blackjetrock/z80_shield/docs/images/c1_soldered.jpg

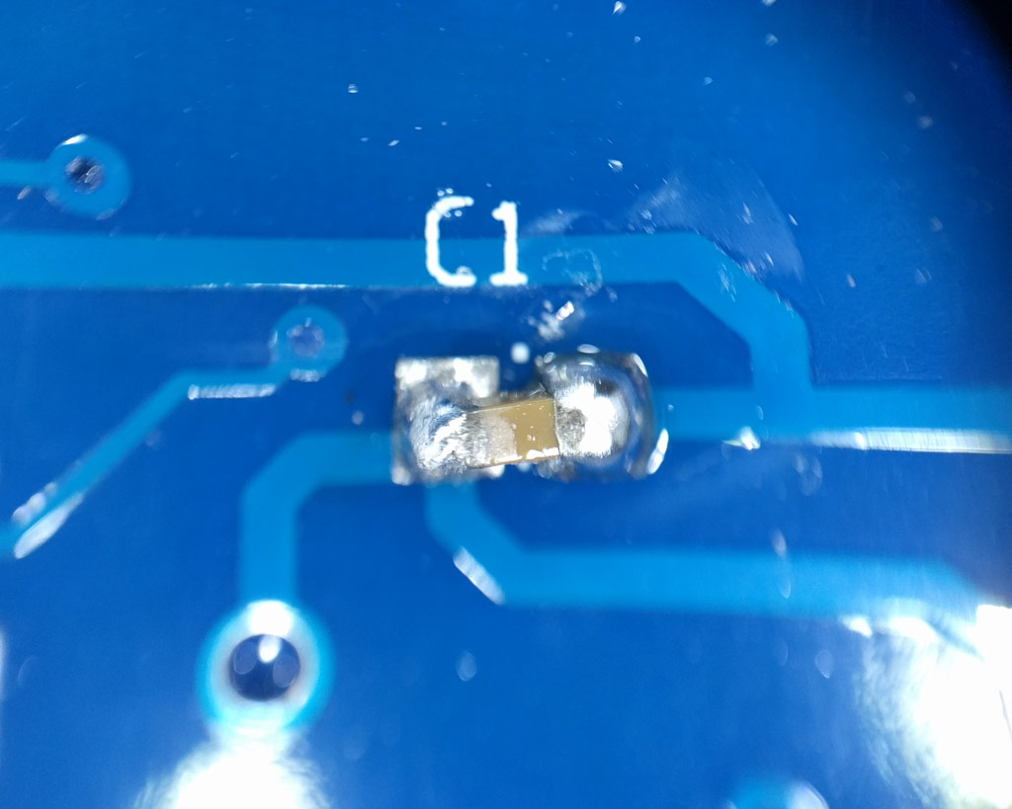
docs/images/c1_soldered.jpg
