blackjetrock/z80_shield/docs/images/fix_wire_connections.jpg

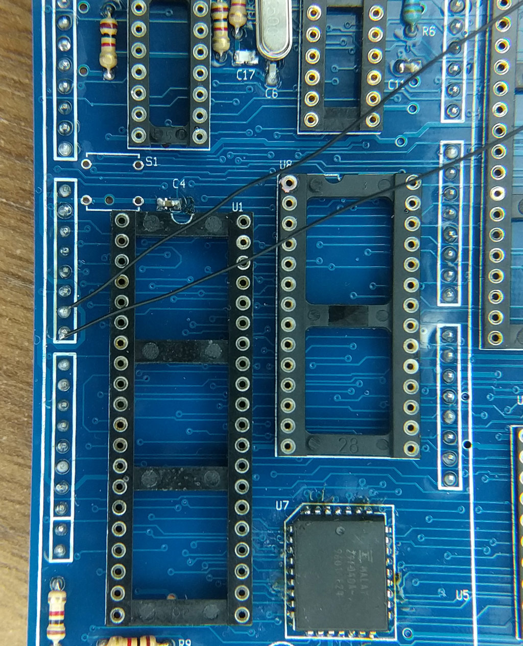
docs/images/fix_wire_connections.jpg
