blackjetrock/z80_shield/datasheets/Pin Arduino Mega 2660.jpg

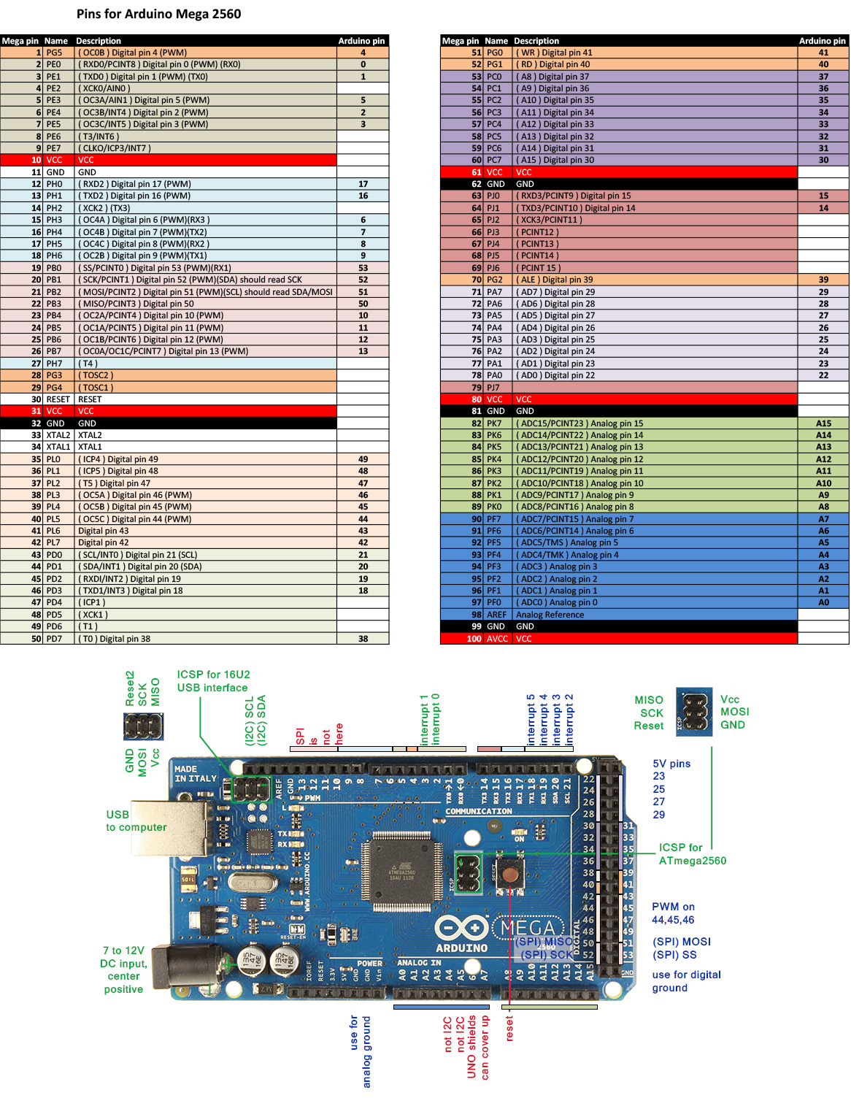
datasheets/Pin Arduino Mega 2660.jpg
