blackjetrock/z80_shield/docs/images/arduino_connectors_prep.jpg

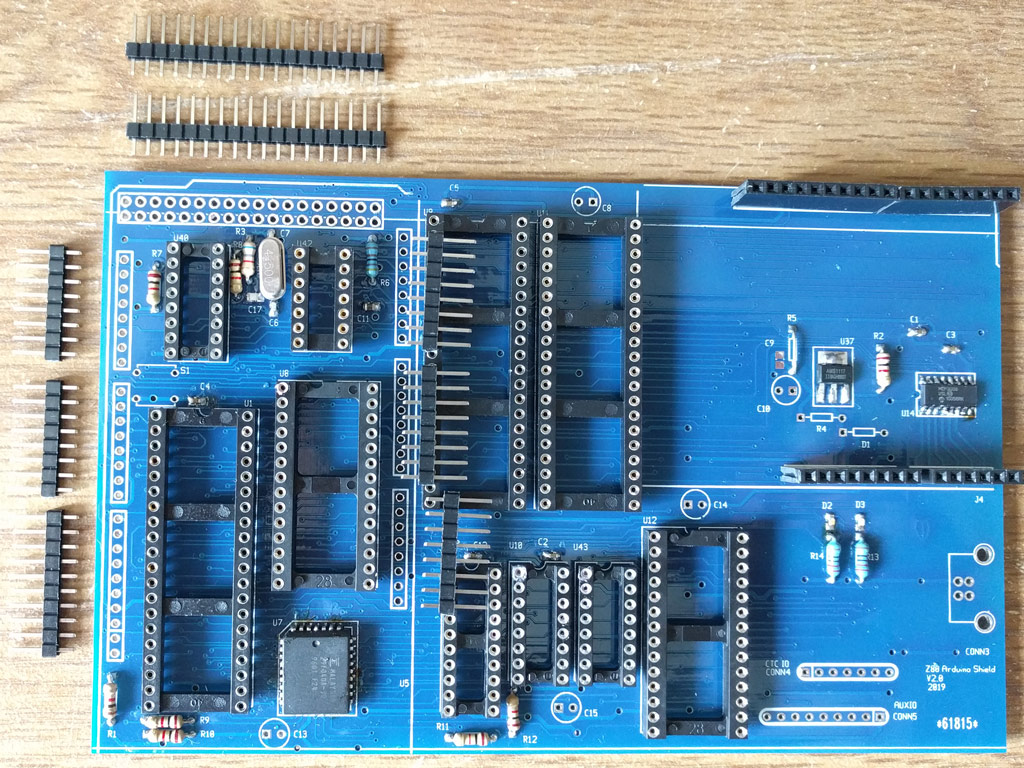
docs/images/arduino_connectors_prep.jpg
