blackjetrock/z80_shield/docs/images/bits.jpg

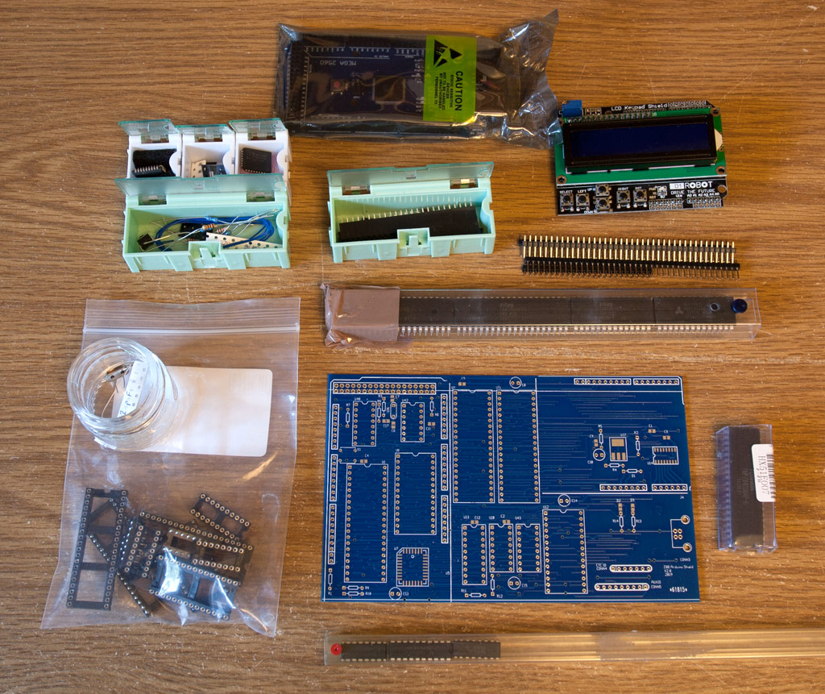
docs/images/bits.jpg
