blackjetrock/z80_shield/docs/images/c1_prep.jpg

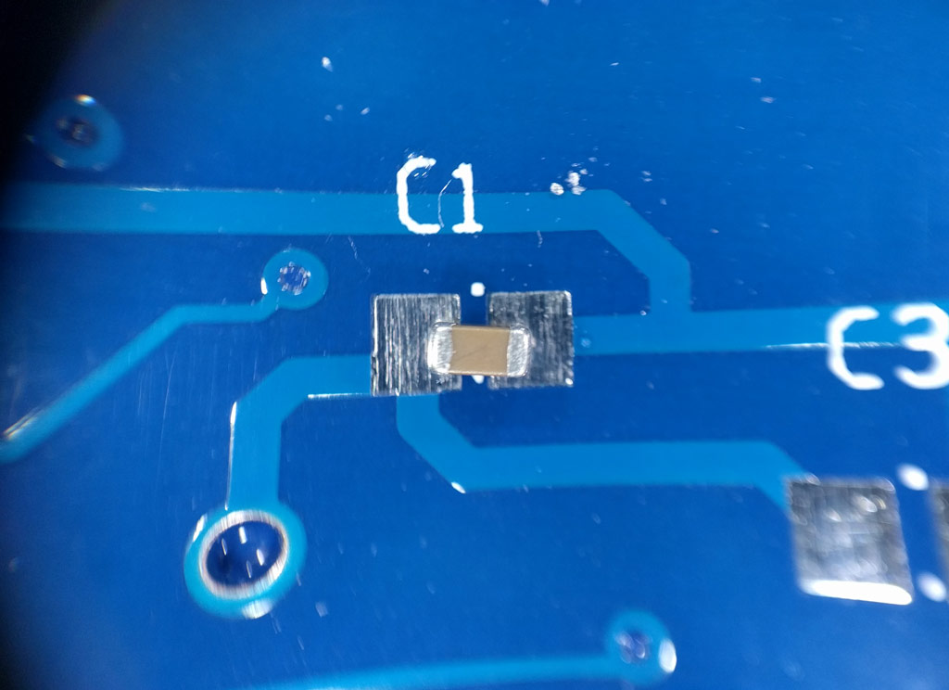
docs/images/c1_prep.jpg
