blackjetrock/z80_shield/docs/images/complete.jpg

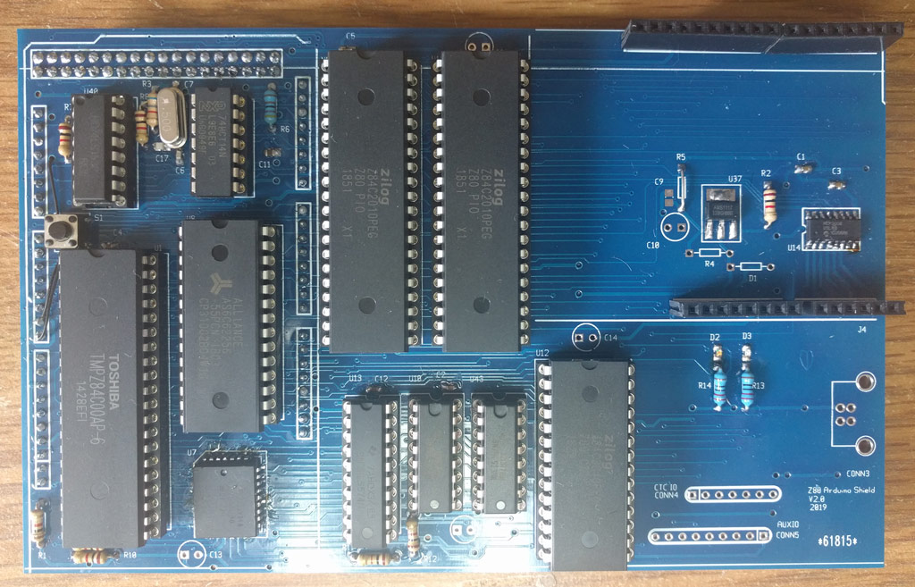
docs/images/complete.jpg
