blackjetrock/z80_shield/docs/images/flash_clamp.jpg

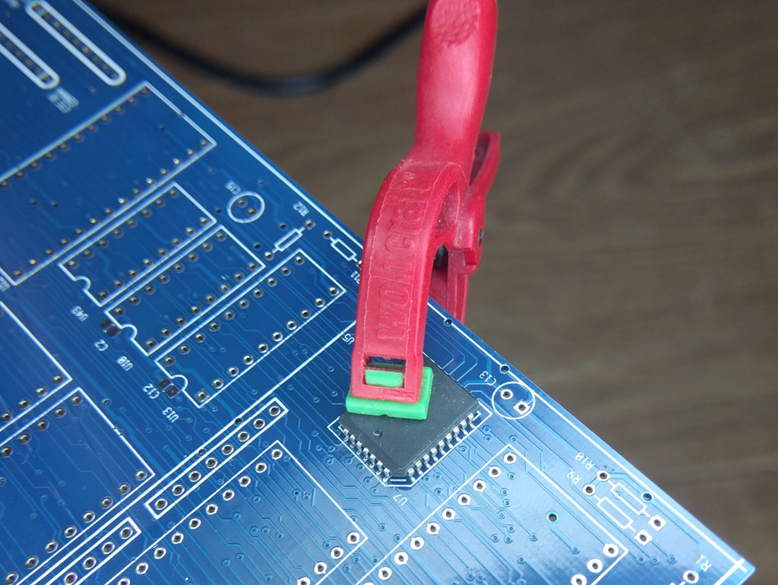
docs/images/flash_clamp.jpg
