blackjetrock/z80_shield/docs/images/flash_clamp_detail.jpg

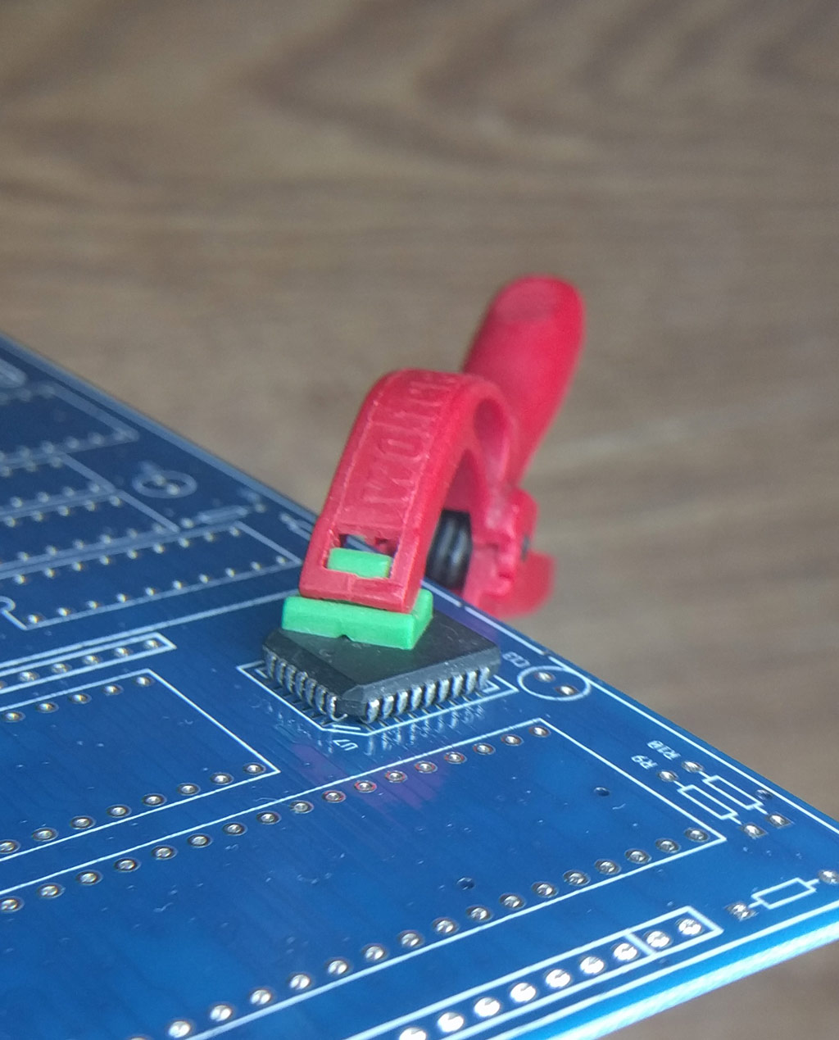
docs/images/flash_clamp_detail.jpg
