blackjetrock/z80_shield/docs/images/flash_prep.jpg

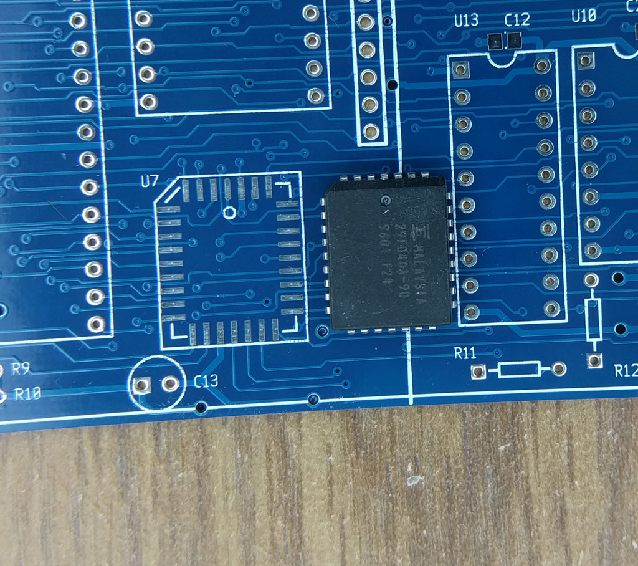
docs/images/flash_prep.jpg
