blackjetrock/z80_shield/docs/images/r5_0ohm.jpg

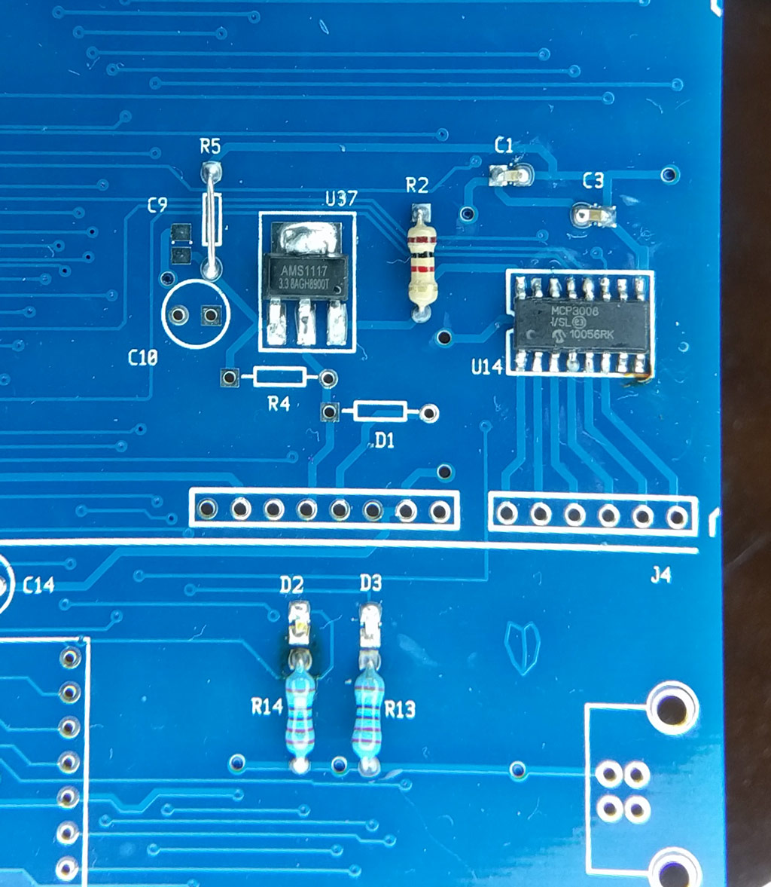
docs/images/r5_0ohm.jpg
