blackjetrock/z80_shield/docs/images/resistors_done.jpg

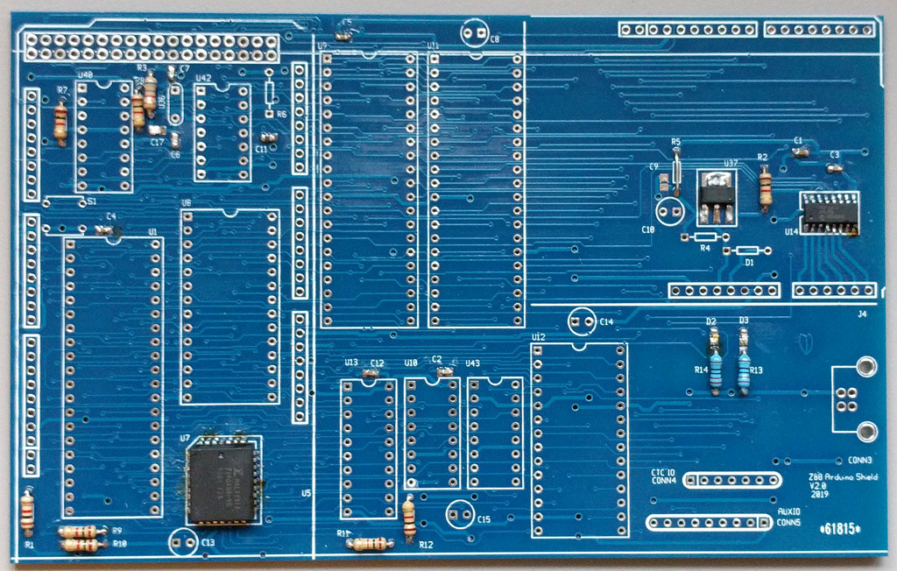
docs/images/resistors_done.jpg
