blackjetrock/z80_shield/docs/images/shield_sockets_prep.jpg

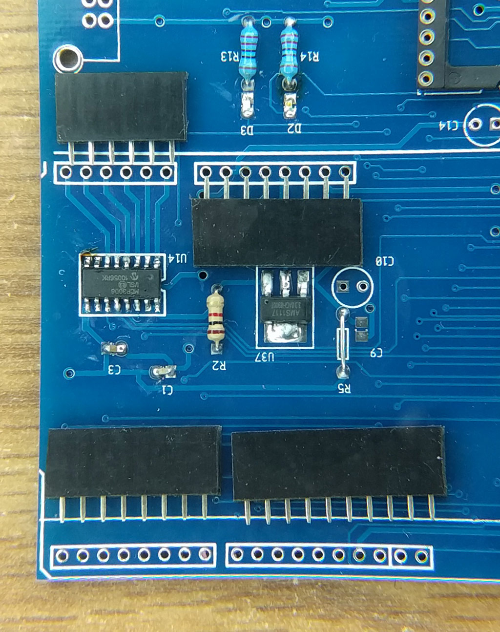
docs/images/shield_sockets_prep.jpg
