blackjetrock/z80_shield/docs/images/sm_done.jpg

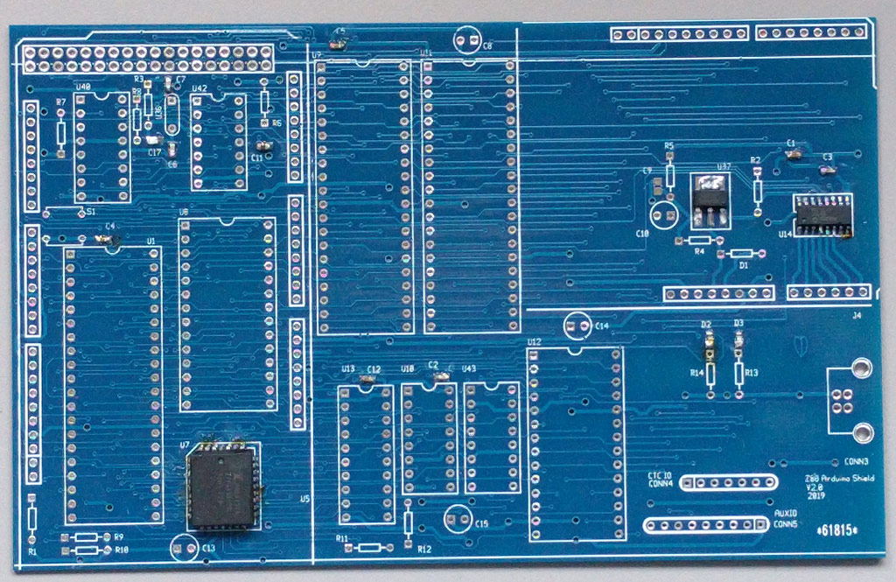
docs/images/sm_done.jpg
