blackjetrock/z80_shield/docs/images/sockets_done.jpg

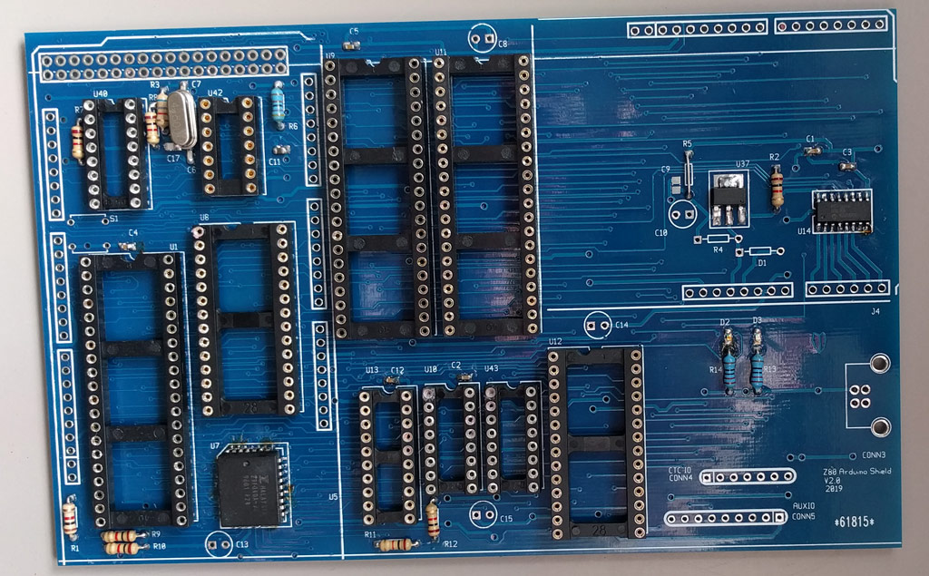
docs/images/sockets_done.jpg
