blackjetrock/z80_shield/docs/images/u9_cuts.jpg

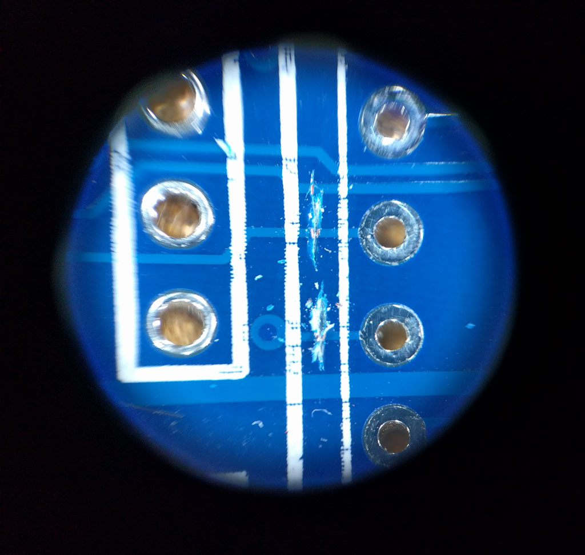
docs/images/u9_cuts.jpg
