blackjetrock/z80_shield/docs/images/u9_switch.jpg

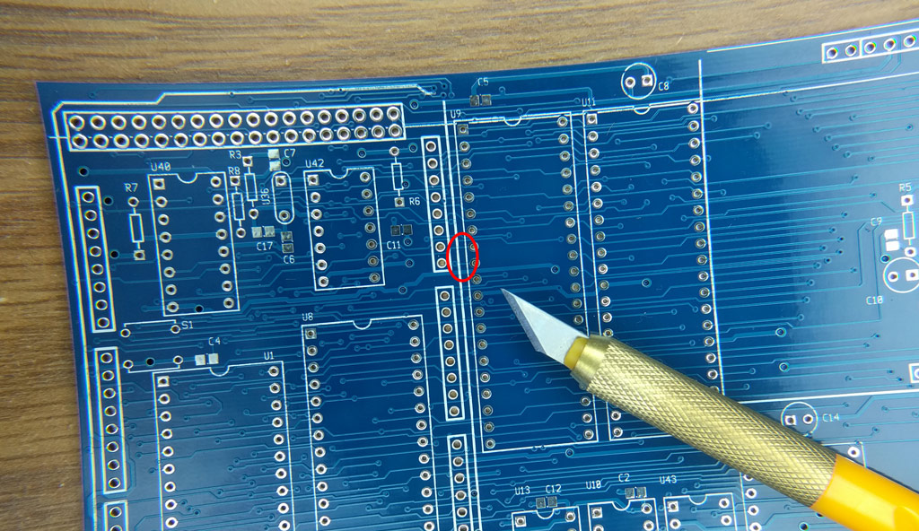
docs/images/u9_switch.jpg
