blackjetrock/z80_shield/docs/images/u14_clamp.jpg

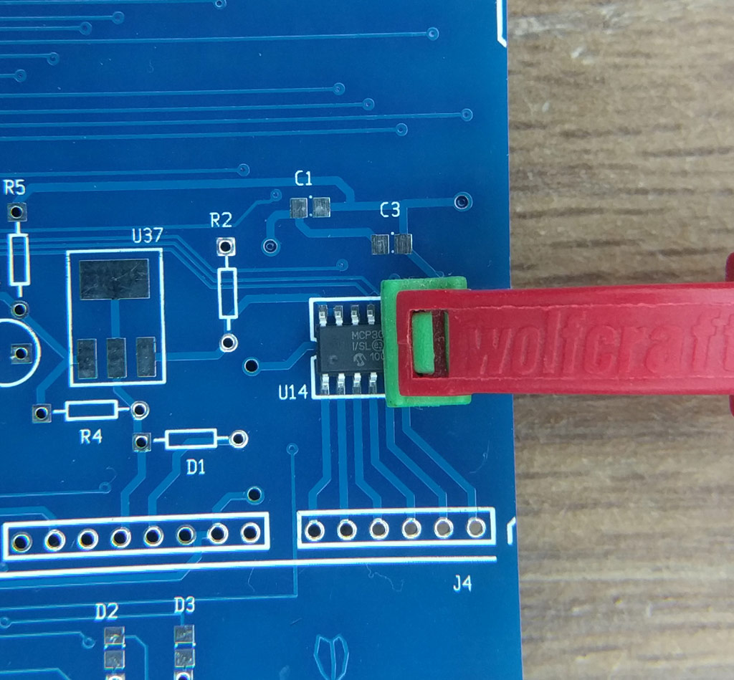
docs/images/u14_clamp.jpg
