blackjetrock/z80_shield/docs/images/u14_prep.jpg

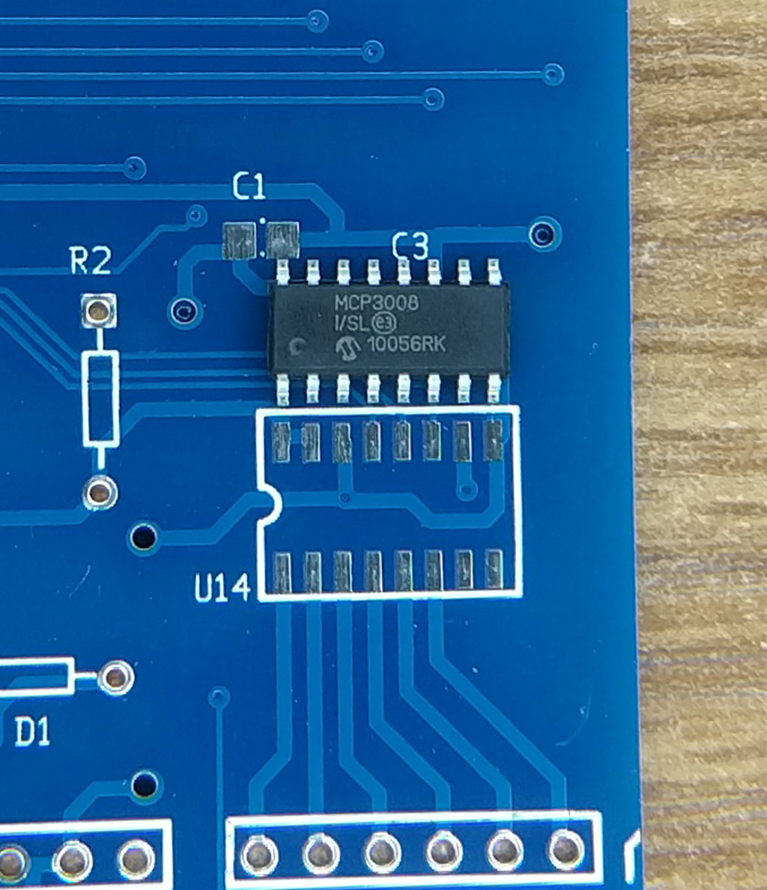
docs/images/u14_prep.jpg
