blackjetrock/z80_shield/docs/images/u36_crystal.jpg

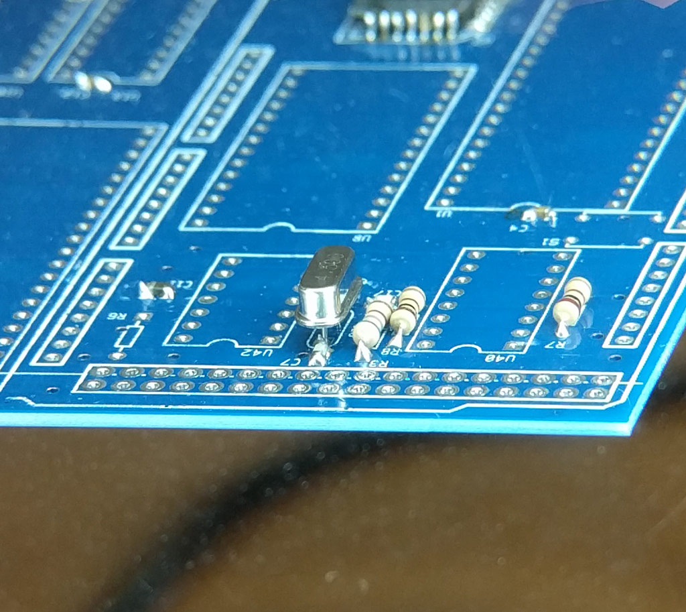
docs/images/u36_crystal.jpg
