blackjetrock/z80_shield/docs/images/u37_prep.jpg

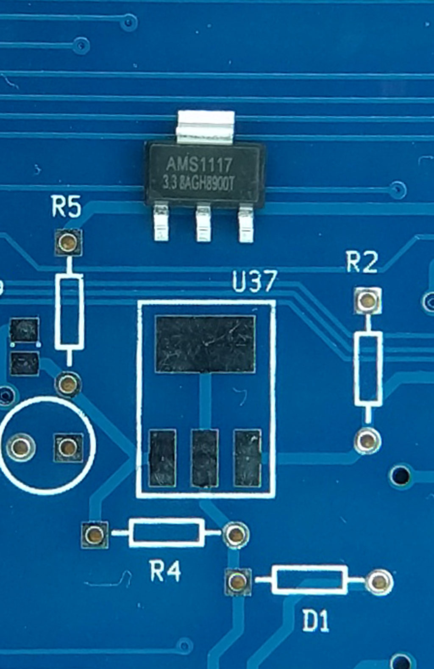
docs/images/u37_prep.jpg
