blackjetrock/z80_shield/docs/images/arduino_connectors_soldered.jpg

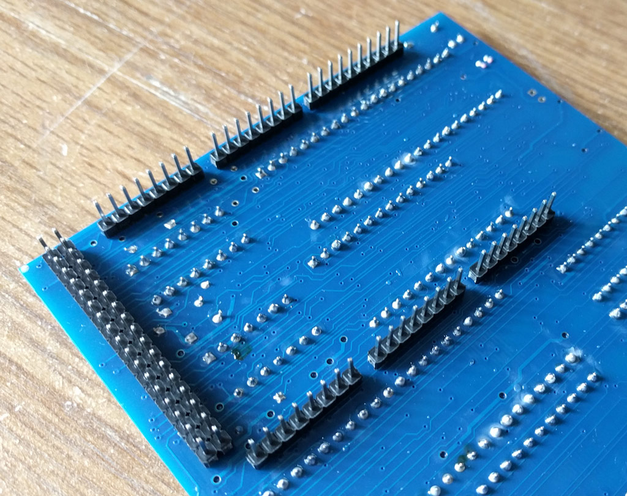
docs/images/arduino_connectors_soldered.jpg
