blackjetrock/z80_shield/docs/images/flash_soldered.jpg

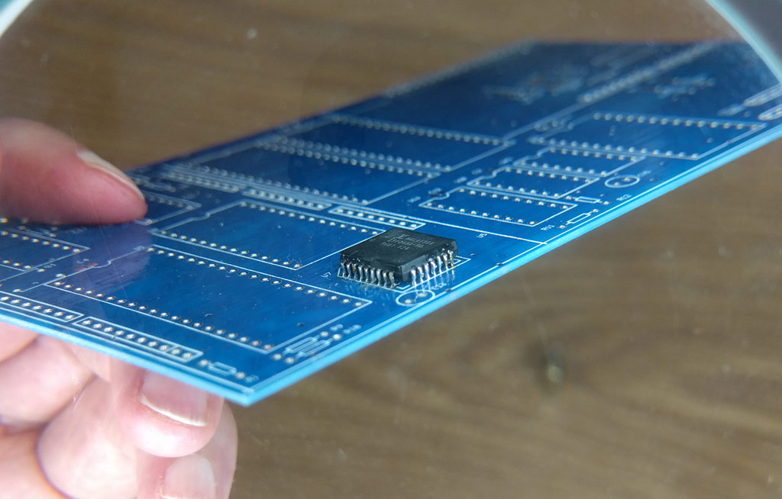
docs/images/flash_soldered.jpg
