blackjetrock/z80_shield/docs/images/shield_sockets_soldered.jpg

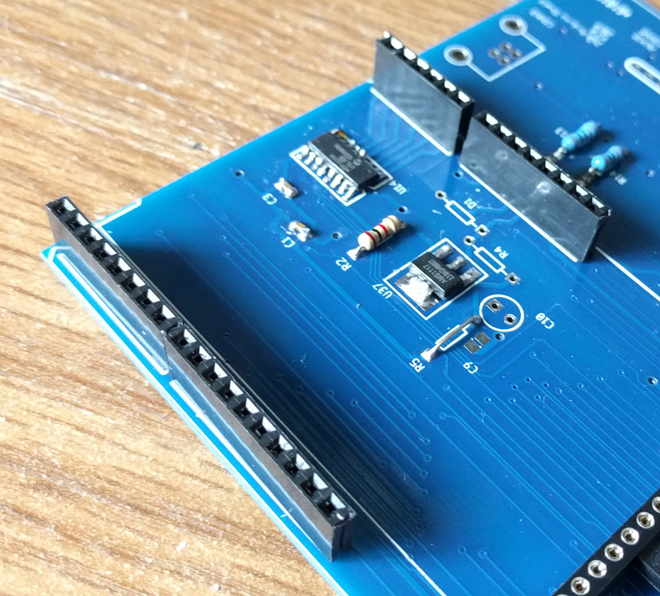
docs/images/shield_sockets_soldered.jpg
