blackjetrock/z80_shield/docs/images/u14_soldered.jpg

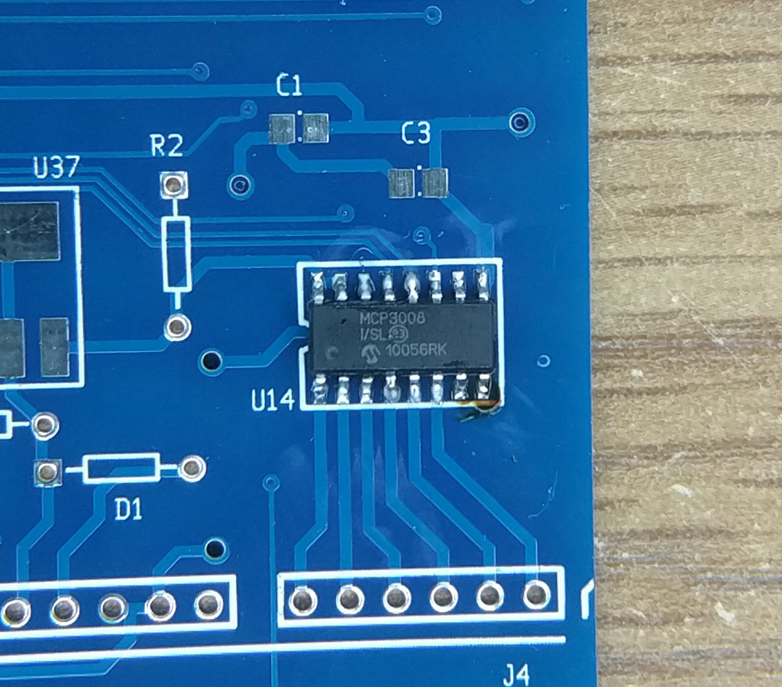
docs/images/u14_soldered.jpg
