blackjetrock/z80_shield/docs/images/u37_soldered.jpg

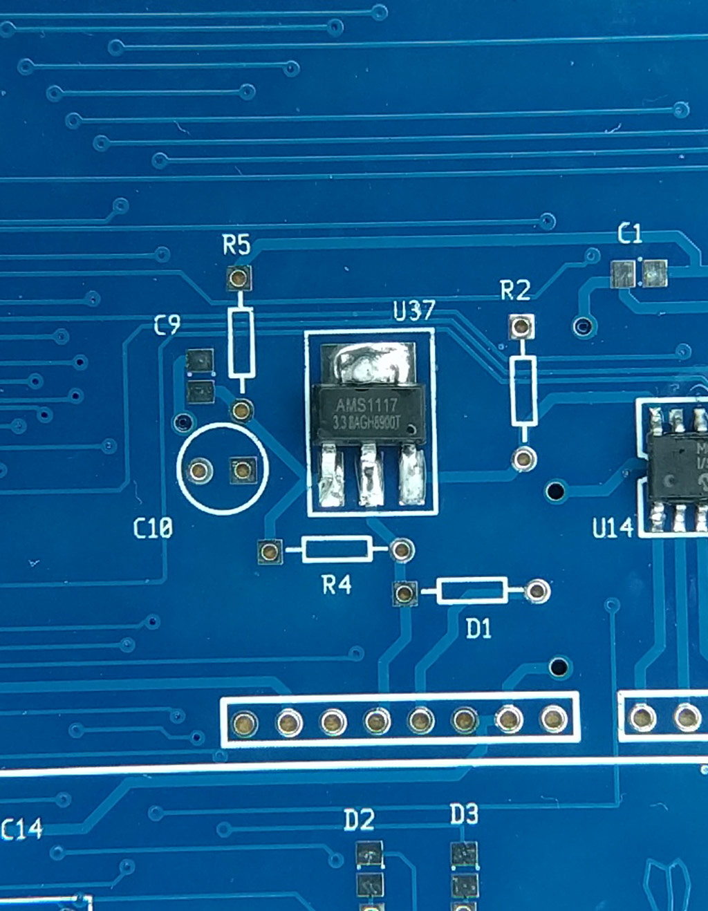
docs/images/u37_soldered.jpg
