blackjetrock/z80_shield/docs/images/fix_wire_topside.jpg

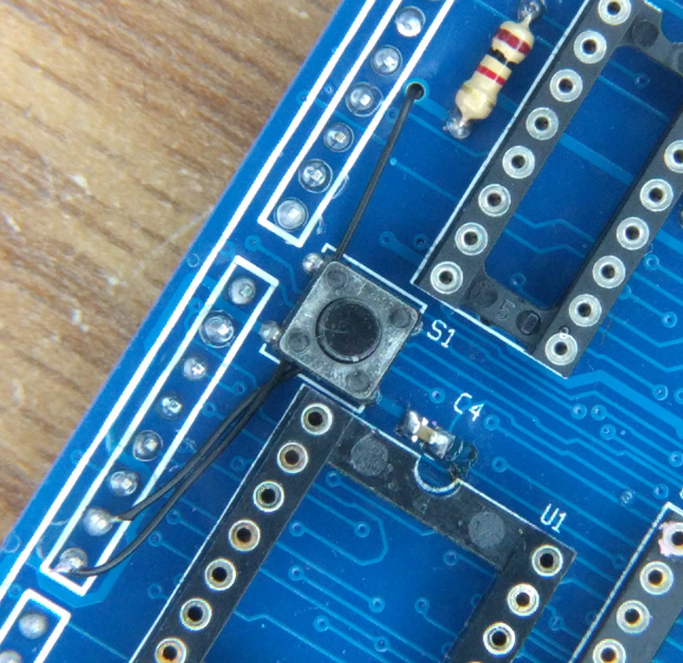
docs/images/fix_wire_topside.jpg
