blackjetrock/z80_shield/docs/images/fix_wire_underside.jpg

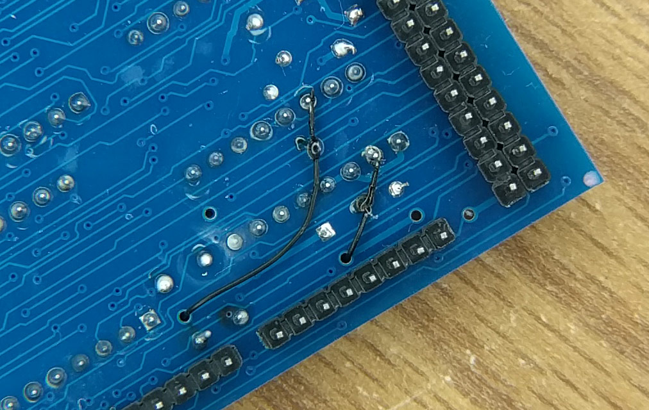
docs/images/fix_wire_underside.jpg
