blackjetrock/z80_shield/z80_shield_v_2_0.pdf

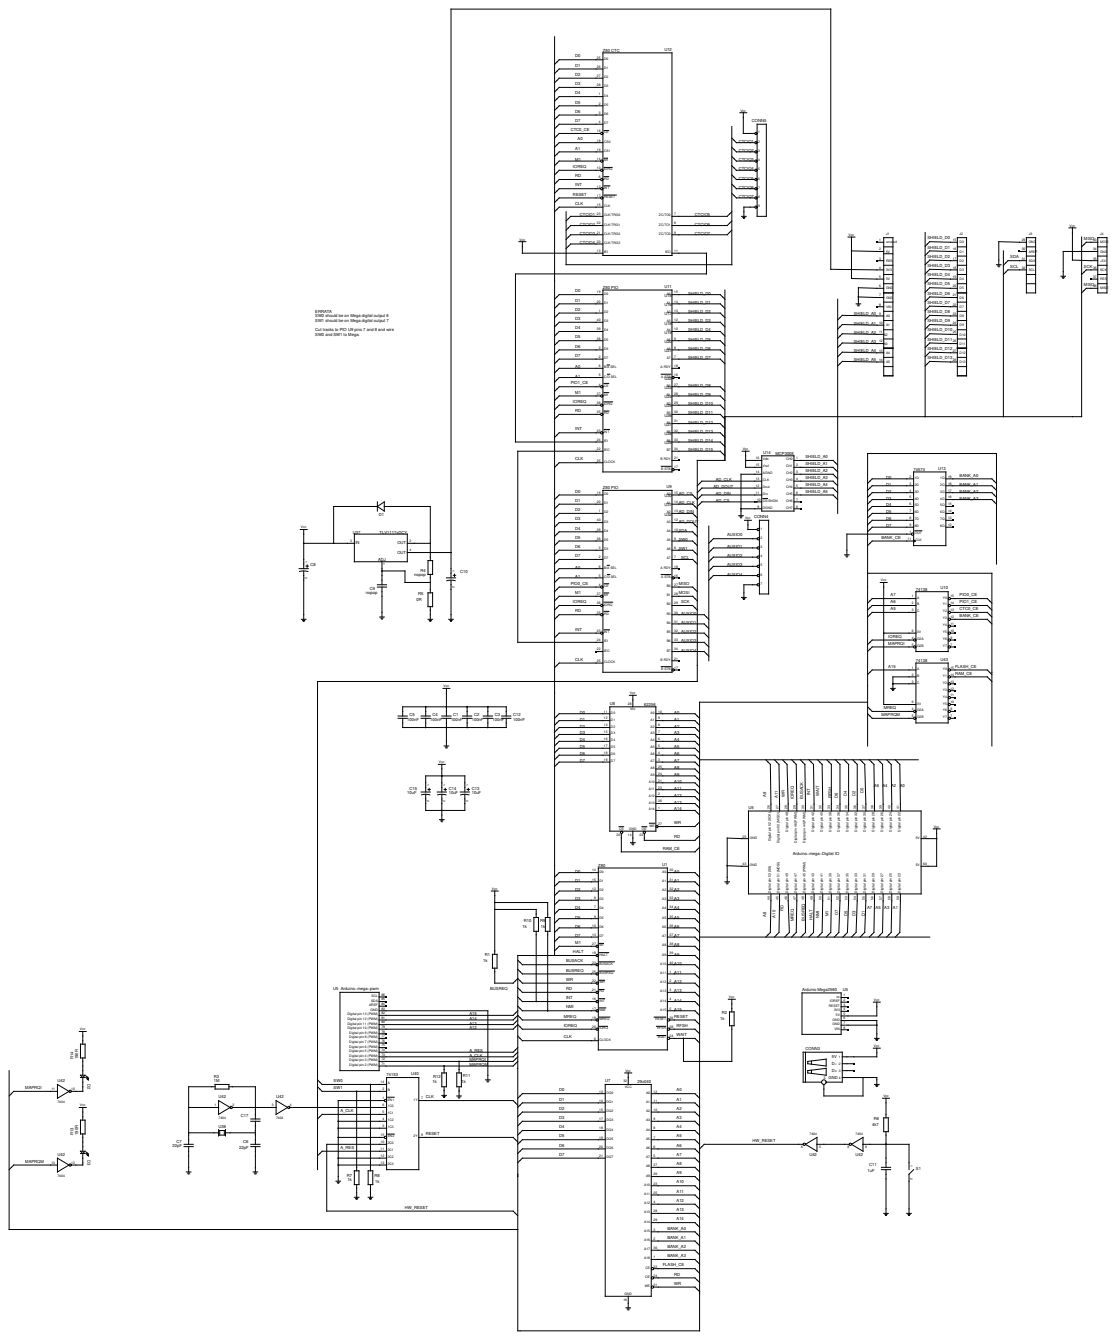
[picture p29: page 1]

CTCIO2 | CTCIO6

CTCIO3 | CTCIO7

19 D0 D1 20 D1 1 D2 40 D3 39 D4 38 D5 3 D3 2 D7 6 B/A SEL 5 C/D SEL 4 CE 37 M1 36 IORQ 35 RD 23 INT 24 IEI 22 IEO 25 CLOCK | U15 U16 U17 U18 U19 U20 U21 | 15 A0 14 A1 SHIELD_D1 13 A2 12 A3 10 A4 9 A5 8 A6 7 A7 18 A RDY

ERRATA
SW0 should be on Mega digital output 6
SW1 should be on Mega digital output 7

D2 | | SHIELD_D2

Cut tracks to PIO U9 pins 7 and 8 and wire
SW0 and SW1 to Mega.

PIO1_CE A1 | U22 U23 U24 U25 U26 U27 U28 U29 | 16 A STB 27 B0 28 B1 29 B2 30 B3 31 B4 32 B5 33 B6 34 B7 21 B RDY

IOREQ | SHIELD_D10

M1 | SHIELD_D9

RD | SHIELD_D11

INT | SHIELD_D12 | U14

D3 | AD_DOUT | D6

C4 100nF Vcc | Vcc C1 C3 C12 100nF 100nF 100nF Vcc | Vcc

D1 12 D1 13 D2 16 D4 15 D3 17 D5 18 D6 19 D7 | Vcc D0 CS GND OE | 10 A0 11 9 A1 A1 8 A2 6 A4 7 A3 5 A5 4 A6 3 A7 25 A8 24 A9 21 A10 23 A11 2 A12 26 A13 1 A14 | MREQ MAPRQM

26 Digital pin 52 (SCK) 44 Digital pin 53 (SS) 25 GND 43 GND Arduino−mega−Digital IO U5

27 Digital pin 50 (MISO) 45 Digital pin 51 (MOSI)

28 Digital pin 48 46 Digital pin 49

29 Digital pin 46 (PWM) 47 Digital pin 47

30 Digital pin 44 (PWM) 48 Digital pin 45 (PWM)

31 Digital pin 42 49 Digital pin 43

32 Digital pin 40 50 Digital pin 41

33 Digital pin 38 51 Digital pin 39

34 Digital pin 36 52 Digital pin 37

35 Digital pin 34 53 Digital pin 35

36 Digital pin 32 54 Digital pin 33

37 Digital pin 30 55 Digital pin 31

38 Digital pin 28 56 Digital pin 29

39 Digital pin 26 57 Digital pin 27

40 Digital pin 24 58 Digital pin 25

41 Digital pin 22 59 Digital pin 23

A_CLK | | RESET | D2 | A2
