blackjetrock/z80_shield/(list of files, drawings)

Other design files:
old_dirty/z80_shield1.pcb
z80_shield1.pcb
z80_shield_v_2_0.pcb
z80_shield_v_2_1.pcb
