blackjetrock/z80_shield/(commit log)

2019-04-18 Initial files
    [z80_shield1.sch]
2019-04-18 Added ADC
    [z80_shield1.sch]
2019-04-18 Updated datasheets and schematic
2019-04-18 Added schematic
    [z80_shield1.sch]
2019-04-19 Added PCB and latest sch changes
    [z80_shield1.pcb]
2019-04-19 PCB created and more datasheets
2019-04-21 Schematic updates and PCB layout started
    [z80_shield1.pcb, z80_shield1.sch]
2019-04-24 More layout, now routed
    [z80_shield1.pcb]
2019-04-24 More changes
    [z80_shield1.sch]
2019-04-25 Added aux io connectors
    [z80_shield1.sch]
2019-04-25 Fully routed and design rule checked
    [z80_shield1.pcb]
2019-04-26 Added A0/A1 to PIOs
    [z80_shield1.sch]
2019-04-26 laid out and titles added. Silk tidied. traxcks tidied. DRC fine, apart from via size and silk line thickness.
    [z80_shield1.pcb]
2019-05-02 Minor changes
    [z80_shield1.pcb]
2019-05-02 Added Dirty PCBs Zip files. V1_1 was sent off for sirst batch
2019-05-02 Start of V1.2 changes
    [z80_shield1.sch]
2019-05-02 Start of V1.2 fixes
    [z80_shield1.pcb]
2019-05-03 Mega sketch updates and errata changes
    [z80_shield.ino]
2019-05-03 More errata and some more code for Mega
    [z80_shield.ino]
2019-05-03 Fixed items 4 and 5 (NT and NMI) in errata
    [z80_shield1.pcb, z80_shield1.sch]
2019-05-11 Added RFSH pin and cage layout pins
2019-05-12 Modified pinout to match rewired bad Mega layout
    [z80_shield1.pcb, z80_shield1.sch]
2019-05-20 Added code to write to RAM and also to bank register Runs on V1_1 PCB.
2019-05-20 Added V1_1 PCB files, or a close as i can get. Should have copied them.
    [z80_shield_v_1_1.pcb, z80_shield_v_1_1.sch]
2019-05-20 Added old pcb and sch files for archive purposes
    [z80_shield1.pcb, z80_shield1.sch]
2019-05-21 Added forever loop command and more errata
    [z80_shield.ino]
2019-05-22 Added Z80 code and fixed memory menu
    [z80_shield.ino]
2019-05-22 Fixes ot memory menu
    [z80_shield.ino]
2019-05-24 Added errata Changed the memory access when tracing so that the RAM chipprovides RAM data. Moved data bus driving to bus state machine to do this. Added more Z80 code
    [z80_shield.ino]
2019-05-24 LCD Test working. Added V2 PCB and schematic. Added Z80 code examples
    [z80_shield_v_2_0.pcb, z80_shield_v_2_0.sch]
2019-05-25 Improved lcd test, added errata and some updates to V2 schematic
    [z80_shield_v_2_0.sch]
2019-05-28 Updated V2 schematic and PCB
    [z80_shield_v_2_0.pcb, z80_shield_v_2_0.sch]
2019-05-28 Delete z80_shield_v_2_0.pcb
    Deleting to get newer V2 file
    [z80_shield_v_2_0.pcb]
2019-05-28 Delete z80_shield_v_2_0.sch
    Deleting to get newer version
    [z80_shield_v_2_0.sch]
2019-05-28 Added new version 2 files
    [z80_shield_v_2_0.pcb, z80_shield_v_2_0.sch]
2019-05-28 PCB work
    [z80_shield_v_2_0.pcb]
2019-05-29 More routing
    [z80_shield_v_2_0.pcb, z80_shield_v_2_0.sch]
2019-05-31 V2.0 PCB that passes design rule check at 4mil, so probably ok for 6.
    [z80_shield_v_2_0.pcb, z80_shield_v_2_0.sch]
2019-05-31 More fixes, errors on schematic mainly.
    [z80_shield_v_2_0.pcb, z80_shield_v_2_0.sch]
2019-06-04 Final changes for V2. Added LEDs to MAPRQI and MAPRQM
    [z80_shield_v_2_0.pcb, z80_shield_v_2_0.sch]
2019-06-04 Changes to silk after viewing gerbers.
    [z80_shield_v_2_0.pcb]
2019-06-04 Another silk mod
    [z80_shield_v_2_0.pcb]
2019-06-14 Final changes before second PCB run.
    [z80_shield_v_2_0.pcb]
2019-06-23 Changes and new bom file for V2.0 PCB. Arduino sketch is now set up for V2.0 PCB.
2019-06-24 Embedded symbols in schematic
    [z80_shield_v_2_0.sch]
2019-09-03 A/D now sampling. Lcdtest Z80 code has sample display after LCD write.
2019-09-04 print addr or PC depending on M1 state
2019-09-04 add Z80 reset to main menu
    [z80_shield.ino]
2019-09-06 Swapped map request assertion messages
    [z80_shield.ino]
2019-09-06 Added upload fixes to both sides. Still doesn't send file
    [z80_shield.ino]
2019-09-06 tidy up trace menu
2019-09-22 PCB fixes and changes for V2.1 PCB
    [z80_shield_v_2_1.pcb, z80_shield_v_2_1.sch]
2019-09-23 Added VREF jumpers for A/D LED labels now logically correct.
    [z80_shield_v_2_1.pcb, z80_shield_v_2_1.sch]
2019-09-25 strip out my test code, it takes too much room
    [z80_shield.ino]
2019-10-02 clean up the memory menu UI, NOT WORKING PROPERLY
    [z80_shield.ino]
2019-10-22 Added portC line as comment for direct data bus access. Looks like the bus is wired the wrong way round for direct access.
    [z80_shield.ino]
2019-10-24 Direct port access on address and data bus done. Compile time timing for clock added to trace menu
2019-10-24 Added trace facility so we can do code between instructions (for register dump). It's '-' in trace menu. Some saving of RAM spce as we are short on that and it caused stack overflows.
    [z80_shield.ino]
2019-10-24 Swapped data bus round on Mega so that diret port access is quicker.
    [z80_shield_v_2_1.pcb, z80_shield_v_2_1.sch]
2019-10-25 Fixed 'n' single instruction step command. Uses bus state machine to do stop. Need to look at 'c' command.
    [z80_shield.ino]
2019-10-25 Added an oldest entry marker to trace Made 'c' command work, this fixes #8
    [z80_shield.ino]
2019-10-26 Added the 'g' command that dumps register values. This is incomplete but fundamentally works. It allows arbitrary code to be run between Z80 instructions. The code must affect nothing (unles you want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
    [z80_shield.ino]
2019-10-26 Added a separate trace buffer for inter instruction code. Note that II code in this build requires the SP to be set up as it pushes and pops data.
2019-10-27 Adjusted order that events are raised to fix #9 The M1 and RFSH signals should raise events before RD and WR as they determine the bus cycle type.
    [z80_shield.ino]
2019-10-27 Tidied trace menu items.
2019-10-27 Fixes #10 The register dump now pulls out the standard register set and sp and pc. It's not done automatically after an 'n', but when a 'g' is issued. We need to pull more stuff out, but can do that 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
    [z80_shield.ino]
2019-10-27 Fixes #14 This was a problem with the tracing. Now have a ne wproblem where next 'n' doesn't do an instruction.
    [z80_shield.ino]
2019-10-28 Fixes #14 and makes the 'n' command work better.
    [z80_shield.ino]
2019-10-28 Added script that embeds a .ihx file (ignoring addresses) in the sketch. used so we can have ii code that is assembled by z80asm
2019-10-28 Fixed signal index problem
    [z80_shield.ino]
2019-10-31 Fixed inerston of lcd test code.
    [z80_shield.ino]
2019-11-04 Added SW0 to connector Aded text labels to connectors Fixes #17
    [z80_shield_v_2_1.pcb, z80_shield_v_2_1.sch]
2019-11-05 Added CTC support file. Changed LCD test to display CTC timer value on channel 0 This works when Mega clocked but not when free running.
2019-11-06 Added more register dumping Fixed #20 'n' command now executes a full instruction including prefix opcode and instruction following
    [z80_shield.ino]
2019-11-07 Made register dump history bigger for better debug Fixed #25 (dumping of AF') Fixed #21 (0xCB is a prefix opcode) Other tidying up
    [z80_shield.ino]
2019-11-07 Conditional echo Fixes #27
    [z80_shield.ino]
2019-11-07 Fixed #26 'g' command can not now be interrupted. Will open another issue for the other problem.
    [z80_shield.ino]
2019-11-12 Added disassembly code, but it's turned off as it doesn't work yet.
    [z80_shield.ino]
2020-03-09 More details about the V2.0 PCb modification
2020-03-09 Added errata to schematic
    [z80_shield_v_2_0.sch]
2020-03-09 Added PDF schematic
